teknoman117/KYBERNETES-CHASSIS-SHIELD/README.md

# Kybernetes 2 Chassis Control Shield

Arduino Uno R3 shield for controlling the chassis functions of Kybernetes 2

Schematic

## Functions

* Battery Protection for Motion Battery
* Isolated control of Steering Servos
* Isolated control of ESC
* Kill Switch (ATTINY85) - out of band ESC arming management, Radio PWM input
* Quadrature Encoder Input for velocity control and odometry
* Bumper Input for contact sensors
* I2C bus for current sensors, sonar, imu, etc.

## Firmware

Motion Controller Firmware

Kill Switch Firmware

### Assembled

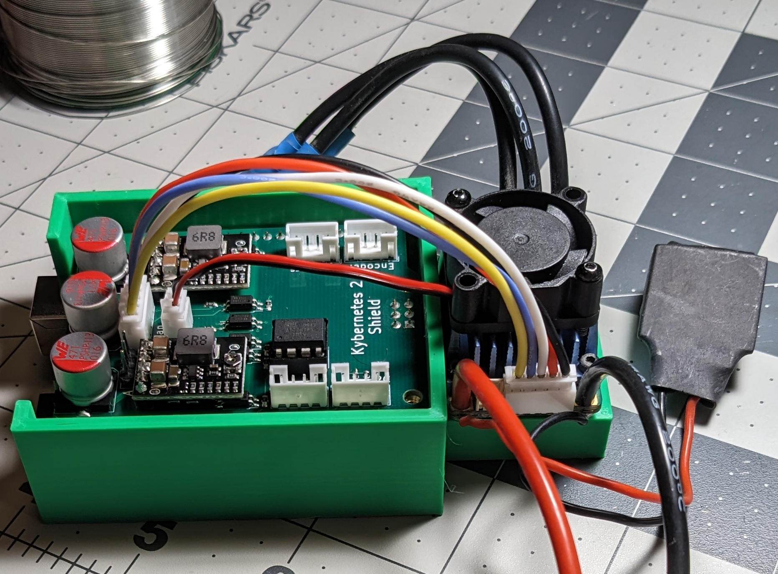
[picture p1: Assets/chassis-shield-assembled.jpg]
Assembled
