teknoman117/KYBERNETES-CHASSIS-SHIELD/Assets/Schematic.pdf

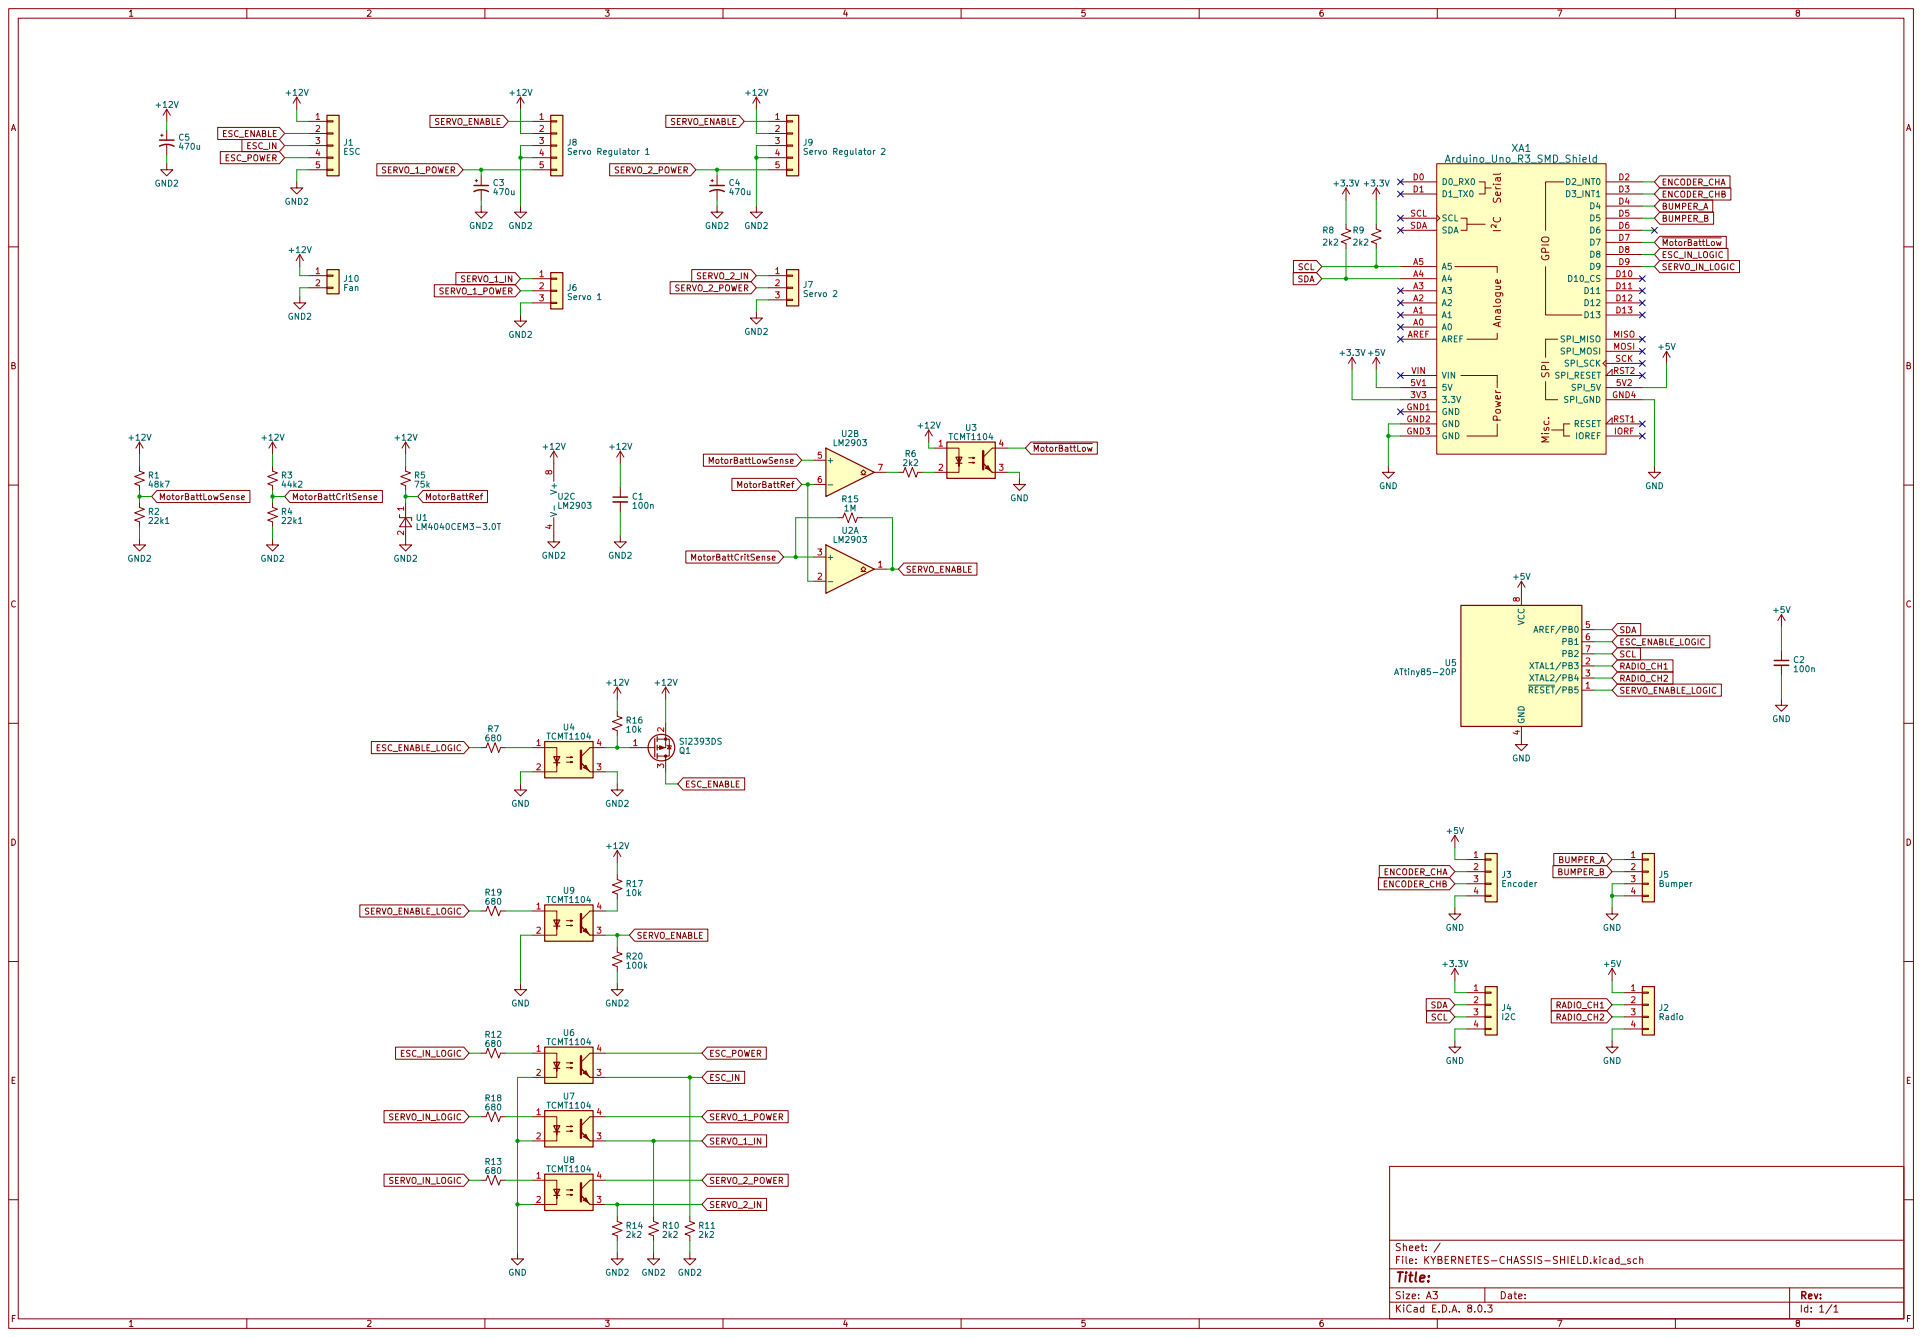
[picture p2: page 1]
