teknoman117/KYBERNETES-CHASSIS-SHIELD/KYBERNETES-CHASSIS-SHIELD.kicad_pcb

## KiCad design KYBERNETES-CHASSIS-SHIELD.kicad_pcb (2023-03-15)

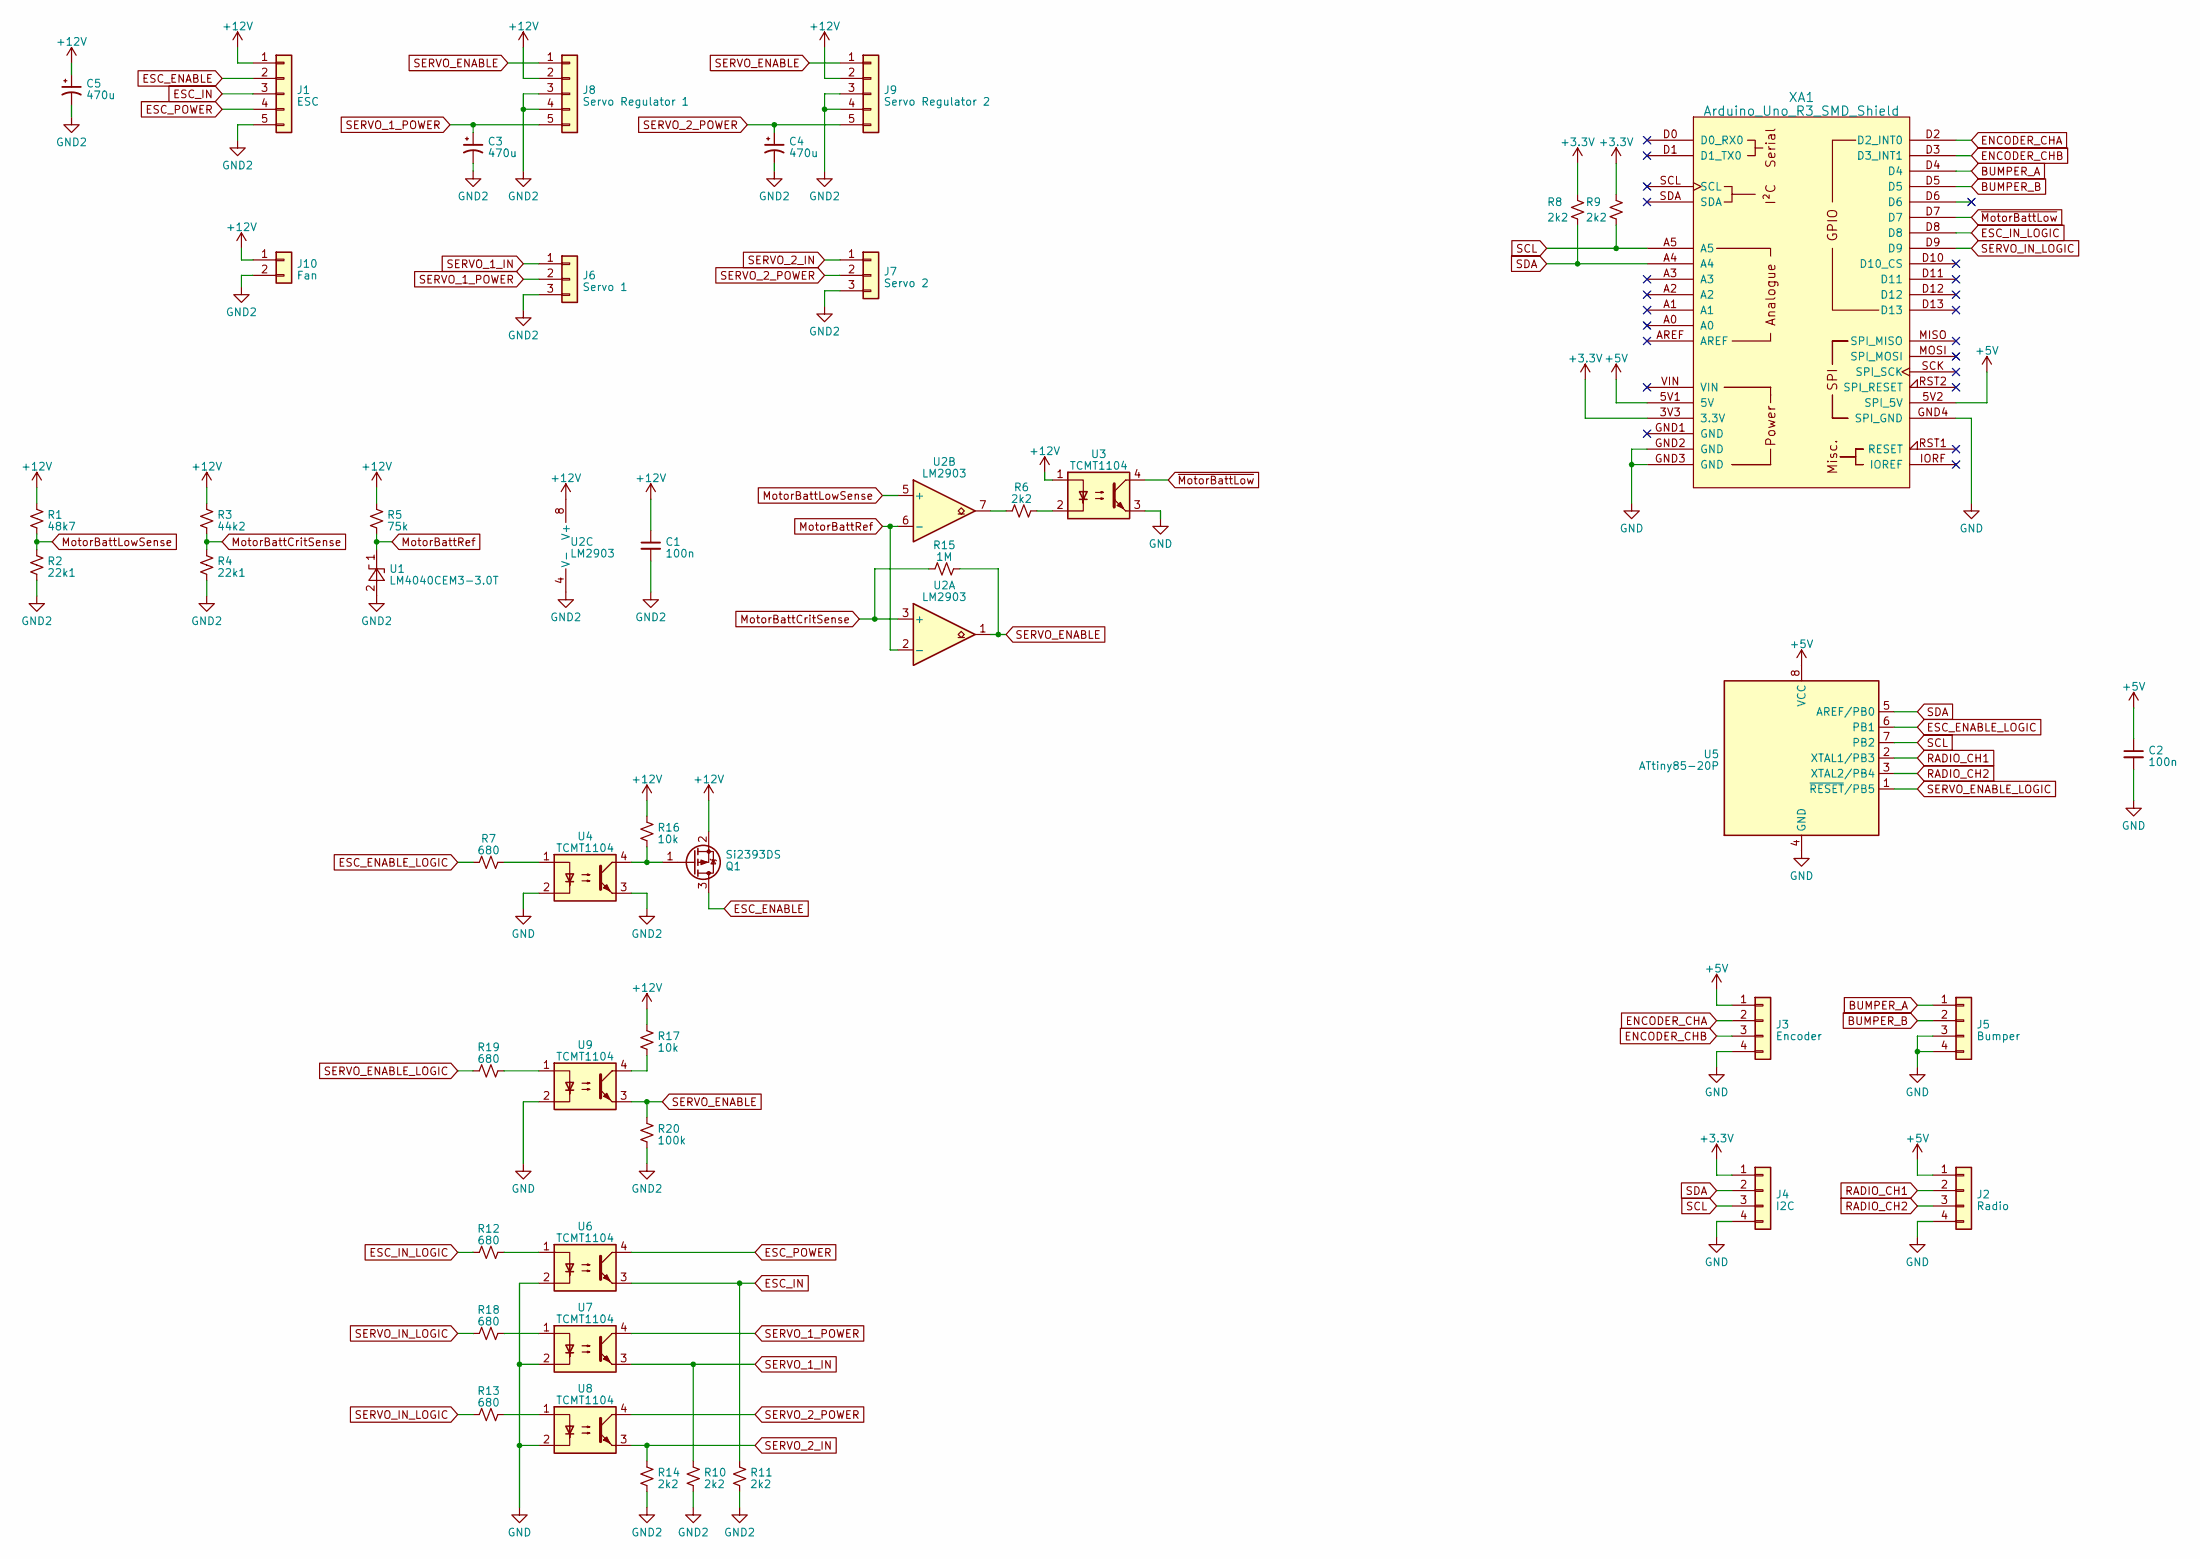
[picture p3: schematic KYBERNETES-CHASSIS-SHIELD.kicad_sch]

Parts:
C1, C2: 100n; C_0603_1608Metric_Pad1.08x0.95mm_HandSolder
C3, C4, C5: 470u; CP_Elec_10x10.5
J1: ESC; JST_PH_B5B-PH-K_1x05_P2.00mm_Vertical
J2: Radio; JST_PH_B4B-PH-K_1x04_P2.00mm_Vertical
J3: Encoder; JST_PH_B4B-PH-K_1x04_P2.00mm_Vertical
J4: I2C; JST_PH_B4B-PH-K_1x04_P2.00mm_Vertical
J5: Bumper; JST_PH_B4B-PH-K_1x04_P2.00mm_Vertical
J6: Servo 1; PinHeader_1x03_P2.54mm_Vertical
J7: Servo 2; PinHeader_1x03_P2.54mm_Vertical
J8: Servo Regulator 1; PinHeader_1x05_P2.54mm_Vertical
J9: Servo Regulator 2; PinHeader_1x05_P2.54mm_Vertical
J10: Fan; JST_PH_B2B-PH-K_1x02_P2.00mm_Vertical
Q1: Si2393DS; SOT-23
R1: 48k7; R_0603_1608Metric_Pad0.98x0.95mm_HandSolder
R2, R4: 22k1; R_0603_1608Metric_Pad0.98x0.95mm_HandSolder
R3: 44k2; R_0603_1608Metric_Pad0.98x0.95mm_HandSolder
R5: 75k; R_0603_1608Metric_Pad0.98x0.95mm_HandSolder
R6, R8, R9, R10, R11, R14: 2k2; R_0603_1608Metric_Pad0.98x0.95mm_HandSolder
R7, R12, R13, R18, R19: 680; R_0603_1608Metric_Pad0.98x0.95mm_HandSolder
R15: 1M; R_0603_1608Metric_Pad0.98x0.95mm_HandSolder
R16, R17: 10k; R_0603_1608Metric_Pad0.98x0.95mm_HandSolder
R20: 100k; R_0603_1608Metric_Pad0.98x0.95mm_HandSolder
U1: LM4040CEM3-3.0T; SOT-23-3
U2: LM2903; TSSOP-8_4.4x3mm_P0.65mm
U3, U4, U6, U7, U8, U9: TCMT1104; SOP-4_4.4x2.6mm_P1.27mm
U5: ATtiny85-20P; DIP-8_W7.62mm
XA1: Arduino_Uno_R3_SMD_Shield; Arduino_Uno_R3_Shield

Connections:
+3.3V: J4.1, R8.1, R9.1, XA1.3V3 (3.3V)
+5V: C2.1, J2.1, J3.1, U5.8 (VCC), XA1.5V1 (5V), XA1.5V2 (SPI_5V)
+12V: C1.1, C5.1, J1.1, J8.2, J9.2, J10.1, Q1.2 (S), R1.1, R3.1, R5.1, R16.1, R17.1, U2.8 (V+), U3.1
BUMPER_A: J5.1, XA1.D4
BUMPER_B: J5.2, XA1.D5
ENCODER_CHA: J3.2, XA1.D2 (D2_INT0)
ENCODER_CHB: J3.3, XA1.D3 (D3_INT1)
ESC_ENABLE: J1.2, Q1.3 (D)
ESC_ENABLE_LOGIC: R7.1, U5.6 (PB1)
ESC_IN: J1.3, R11.1, U6.3
ESC_IN_LOGIC: R12.1, XA1.D8
ESC_POWER: J1.4, U6.4
GND: C2.2, J2.4, J3.4, J4.4, J5.3, J5.4, U3.3, U4.2, U5.4 (GND), U6.2, U7.2, U8.2, U9.2, XA1.GND2 (GND), XA1.GND3 (GND), XA1.GND4 (SPI_GND)
GND2: C1.2, C3.2, C4.2, C5.2, J1.5, J6.3, J7.3, J8.3, J8.4, J9.3, J9.4, J10.2, R2.2, R4.2, R10.2, R11.2, R14.2, R20.2, U1.2 (A), U2.4 (V-), U4.3
MotorBattCritSense: R3.2, R4.1, R15.1, U2.3 (+)
MotorBattLowSense: R1.2, R2.1, U2.5 (+)
MotorBattRef: R5.2, U1.1 (K), U2.2 (-), U2.6 (-)
unnamed: Q1.1 (G), R16.2, U4.4
unnamed: R6.1, U2.7
unnamed: R6.2, U3.2
unnamed: R7.2, U4.1
unnamed: R12.2, U6.1
unnamed: R13.2, U8.1
unnamed: R17.2, U9.4
unnamed: R18.2, U7.1
unnamed: R19.2, U9.1
RADIO_CH1: J2.2, U5.2 (XTAL1/PB3)
RADIO_CH2: J2.3, U5.3 (XTAL2/PB4)
SCL: J4.3, R9.2, U5.7 (PB2), XA1.A5
SDA: J4.2, R8.2, U5.5 (AREF/PB0), XA1.A4
SERVO_1_IN: J6.1, R10.1, U7.3
SERVO_1_POWER: C3.1, J6.2, J8.5, U7.4
SERVO_2_IN: J7.1, R14.1, U8.3
SERVO_2_POWER: C4.1, J7.2, J9.5, U8.4
SERVO_ENABLE: J8.1, J9.1, R15.2, R20.1, U2.1, U9.3
SERVO_ENABLE_LOGIC: R19.1, U5.1 (~RESET/PB5)
SERVO_IN_LOGIC: R13.1, R18.1, XA1.D9
~MotorBattLow: U3.4, XA1.D7

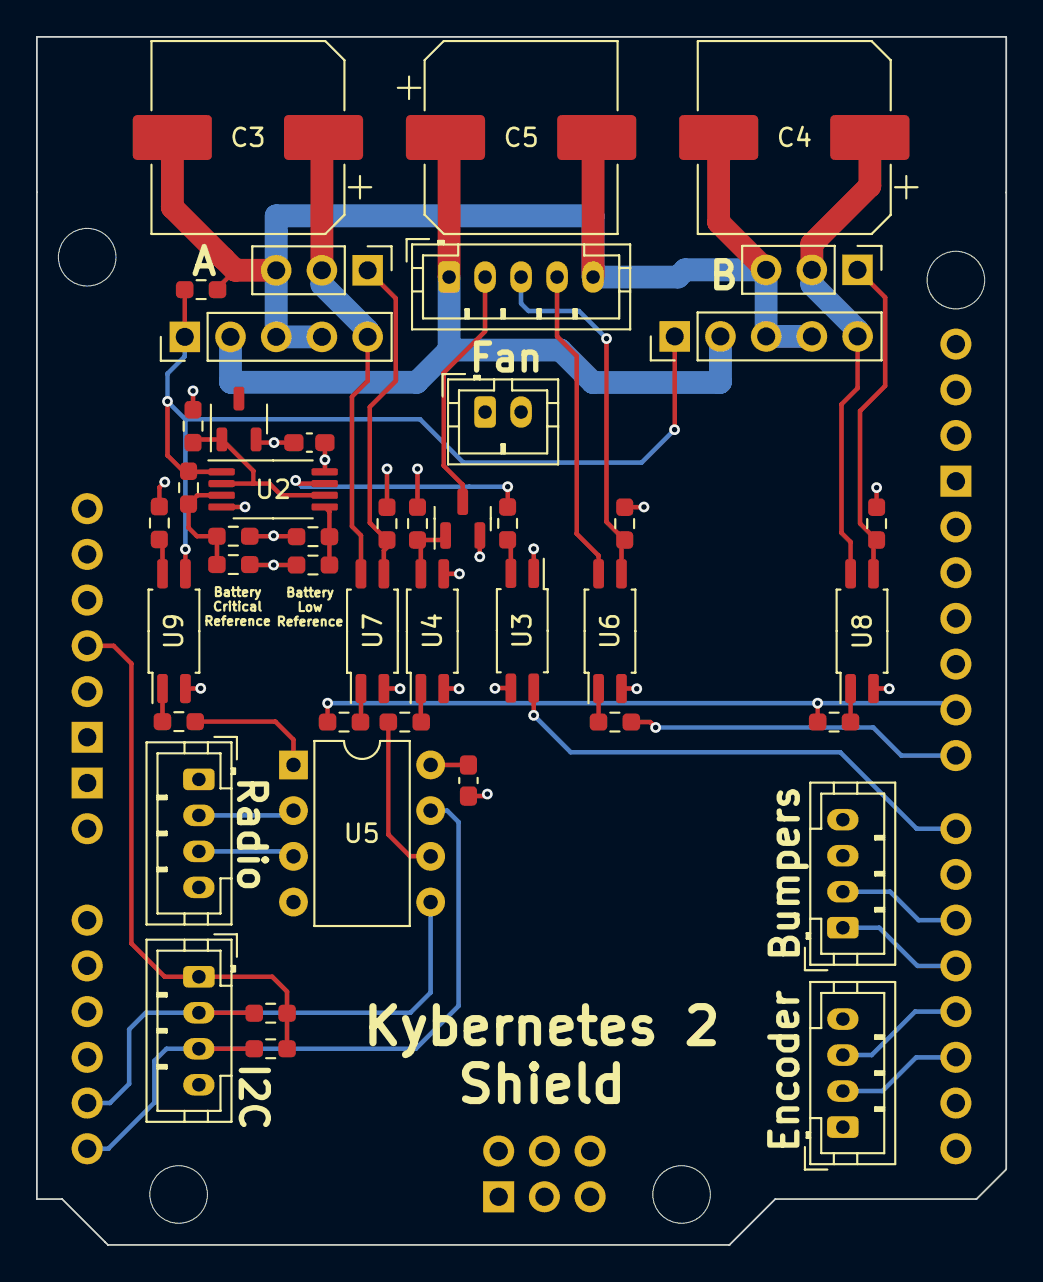
[picture p4: board KYBERNETES-CHASSIS-SHIELD.kicad_pcb from above]

Board: 4 copper layers, 53.8 x 67.1 mm, 46 parts (0 on the bottom side), 38 nets.
