teknoman117/KYBERNETES-CHASSIS-SHIELD/(commit log)

2023-03-01 rework into 4 layer board
    [KYBERNETES-CHASSIS-SHIELD.kicad_pcb, KYBERNETES-CHASSIS-SHIELD.kicad_sch]
2023-03-01 version 1.0
    [KYBERNETES-CHASSIS-SHIELD-B_Cu.gbl, KYBERNETES-CHASSIS-SHIELD-B_Mask.gbs, KYBERNETES-CHASSIS-SHIELD-B_Paste.gbp, KYBERNETES-CHASSIS-SHIELD-B_Silkscreen.gbo, KYBERNETES-CHASSIS-SHIELD-Edge_Cuts.gm1, KYBERNETES-CHASSIS-SHIELD-F_Cu.gtl, KYBERNETES-CHASSIS-SHIELD-F_Mask.gts, KYBERNETES-CHASSIS-SHIELD-F_Paste.gtp]
2023-03-02 add comparator bias resistor, increase low voltage thresholds, add large capacitors for servos
    [KYBERNETES-CHASSIS-SHIELD-B_Cu.gbl, KYBERNETES-CHASSIS-SHIELD-B_Mask.gbs, KYBERNETES-CHASSIS-SHIELD-B_Paste.gbp, KYBERNETES-CHASSIS-SHIELD-B_Silkscreen.gbo, KYBERNETES-CHASSIS-SHIELD-Edge_Cuts.gm1, KYBERNETES-CHASSIS-SHIELD-F_Cu.gtl, KYBERNETES-CHASSIS-SHIELD-F_Mask.gts, KYBERNETES-CHASSIS-SHIELD-F_Paste.gtp]
2023-03-03 fix the incorrect footprint for desired capacitors (wurth 875115357006)
    [KYBERNETES-CHASSIS-SHIELD-B_Cu.gbl, KYBERNETES-CHASSIS-SHIELD-B_Mask.gbs, KYBERNETES-CHASSIS-SHIELD-B_Paste.gbp, KYBERNETES-CHASSIS-SHIELD-B_Silkscreen.gbo, KYBERNETES-CHASSIS-SHIELD-Edge_Cuts.gm1, KYBERNETES-CHASSIS-SHIELD-F_Cu.gtl, KYBERNETES-CHASSIS-SHIELD-F_Mask.gts, KYBERNETES-CHASSIS-SHIELD-F_Paste.gtp]
2023-03-14 add a mosfet after the esc enable opto to as it is not just an enable line as previously thought. needs more current than opto can provide.
    [KYBERNETES-CHASSIS-SHIELD.kicad_pcb, KYBERNETES-CHASSIS-SHIELD.kicad_sch]
2023-03-15 change the servo enable optoisolator to a high side switch
    [KYBERNETES-CHASSIS-SHIELD.kicad_pcb, KYBERNETES-CHASSIS-SHIELD.kicad_sch]
2024-08-16 add schematic rendering
